AJAbanto/OpenEggscale/hardware/STL/lipo-charger-1.snapshot.1/Ladeprint.jpg

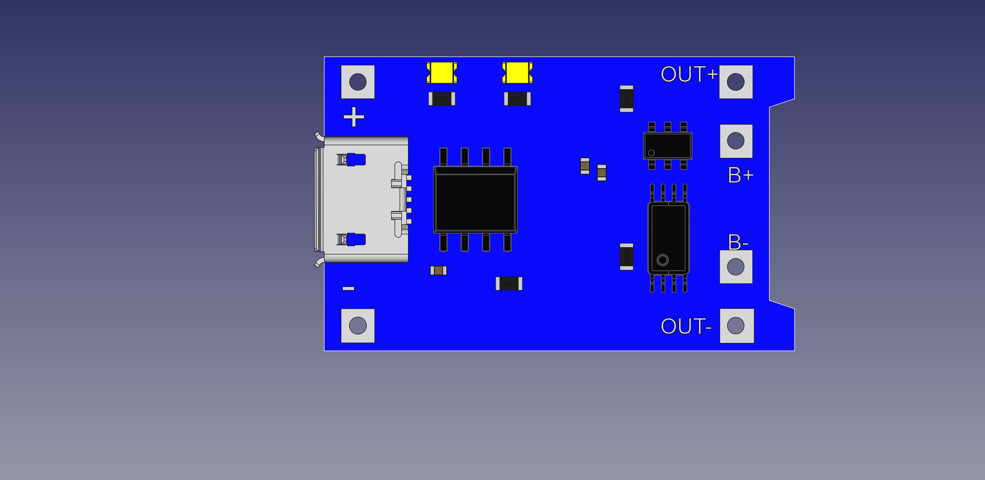
hardware/STL/lipo-charger-1.snapshot.1/Ladeprint.jpg
