AJAbanto/OpenEggscale/hardware/STL/boitier-2-accus-18650-2-slots-18650-battery-holder-1.snapshot.1/Boitier 18650 2 accus.jpg

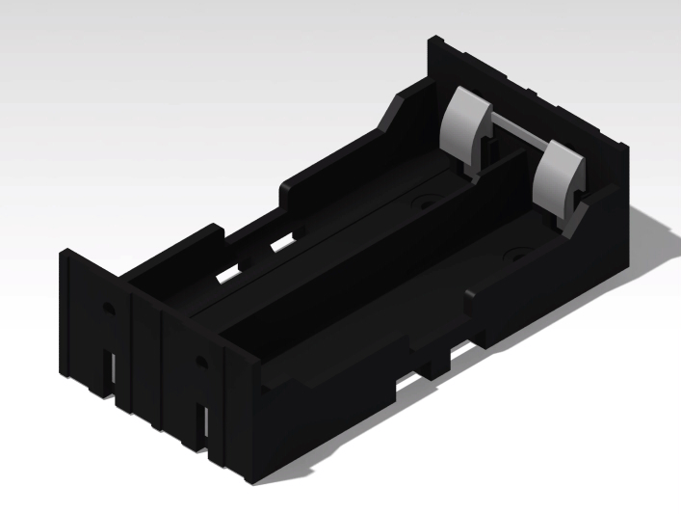
hardware/STL/boitier-2-accus-18650-2-slots-18650-battery-holder-1.snapshot.1/Boitier 18650 2 accus.jpg
