AJAbanto/OpenEggscale/hardware/KiCad/doc/Eggseg_BOM_egizmo.xlsx

Reference | Quantity | Value | Egizmo part | Footprint
C2 C1 | 2 | 22uF | 22UF 80% 25V 0805 | Capacitor_SMD:C_0805_2012Metric_Pad1.15x1.40mm_HandSolder
C3 | 1 | 100uF | 220uF / 10V | Capacitor_THT:CP_Radial_D8.0mm_P3.50mm
D1 | 1 | SS34-E3_57T | SK4200L-TP | SS34-E3_57T:DIOM7959X262N
J1 | 1 | V_charge | HB9500 | TerminalBlock:TerminalBlock_bornier-2_P5.08mm
L1 | 1 | 22uH | Power Inductor SMD 22uH | Inductor_SMD:L_10.4x10.4_H4.8
R3 R2 R1 | 3 | 1K | 1K 5% 0805 | Resistor_SMD:R_0603_1608Metric_Pad1.05x0.95mm_HandSolder
R4 | 1 | 2.2K | 2.2K 5% 0805 | Resistor_SMD:R_0603_1608Metric_Pad1.05x0.95mm_HandSolder
RV1 | 1 | 100K | MT-TR-200K64Z | Potentiometer_THT:Potentiometer_Bourns_3266W_Vertical
SW4 | 1 | PWR_SW | Toggle switch | Connector_PinHeader_2.54mm:PinHeader_1x03_P2.54mm_Vertical
U2 | 1 | MT3608 | MT3608 | Package_TO_SOT_SMD:SOT-23-6
