AJAbanto/OpenEggscale/hardware/STL/Base plate.stl

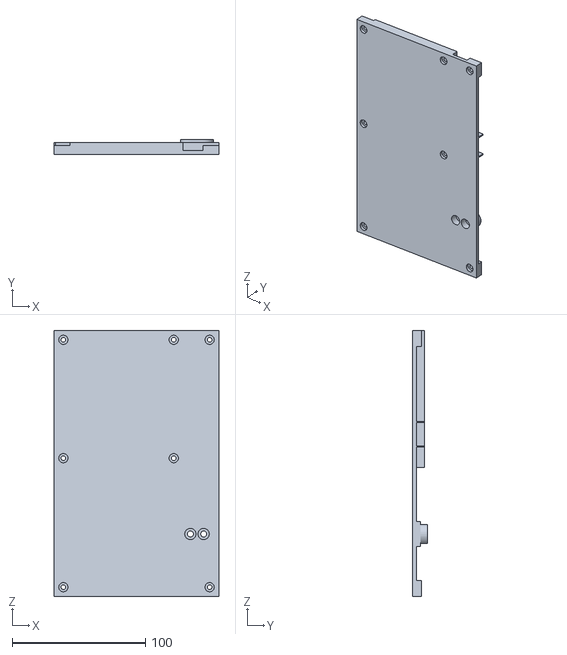
[picture p3: CAD file, 2020-08-23]
hardware/STL/Base plate.stl
124.0 x 11.5 x 200.0
