AJAbanto/OpenEggscale/hardware/STL/boitier-2-accus-18650-2-slots-18650-battery-holder-1.snapshot.1/Boitier 18650 2 accus.stp

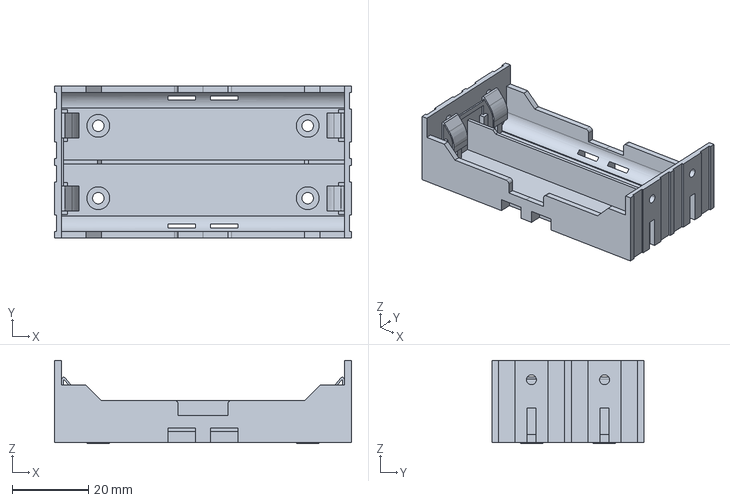
[picture p4: CAD file, 2020-08-23]
hardware/STL/boitier-2-accus-18650-2-slots-18650-battery-holder-1.snapshot.1/Boitier 18650 2 accus.stp
78.0 x 40.0 x 21.8 mm
