AJAbanto/OpenEggscale/hardware/STL/Eggplate.stl

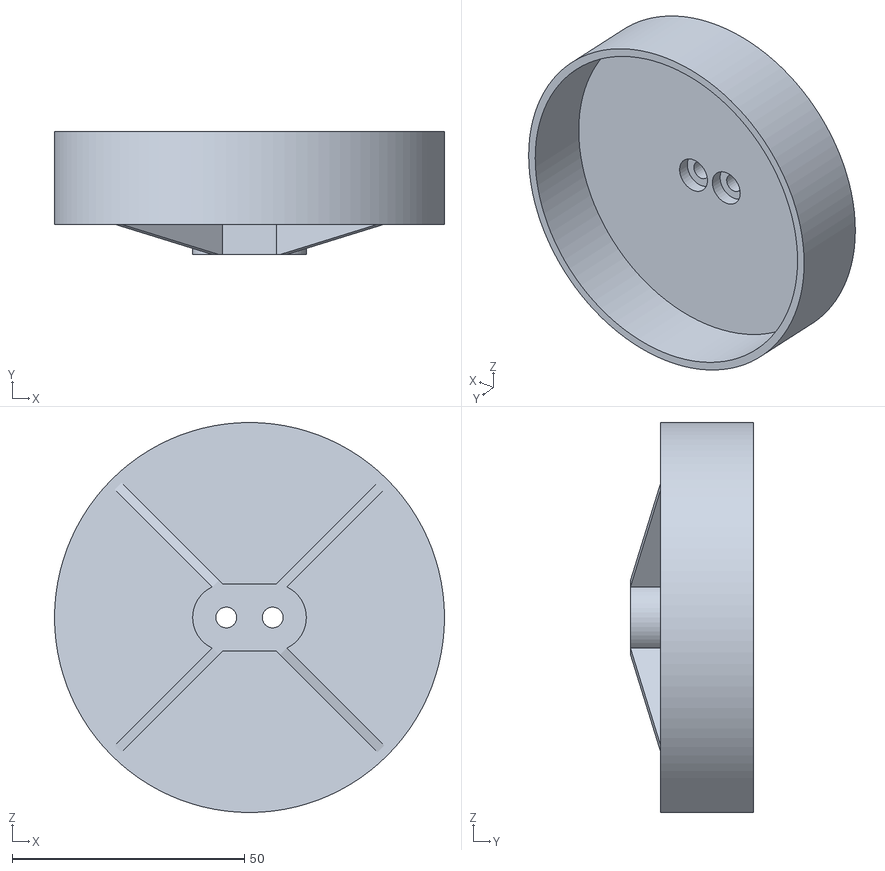
[picture p5: CAD file, 2020-08-12]
hardware/STL/Eggplate.stl
84.0 x 26.5 x 84.0
