AJAbanto/OpenEggscale/hardware/STL/menu button extension.stl

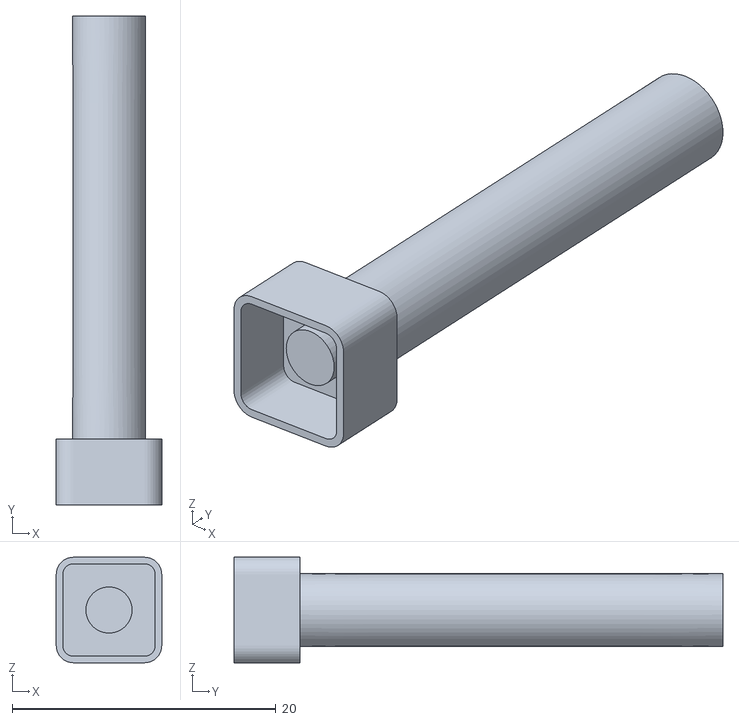
[picture p6: CAD file, 2020-08-12]
hardware/STL/menu button extension.stl
8.00 x 37.1 x 8.00
