AJAbanto/OpenEggscale/hardware/STL/Cover plate.stl

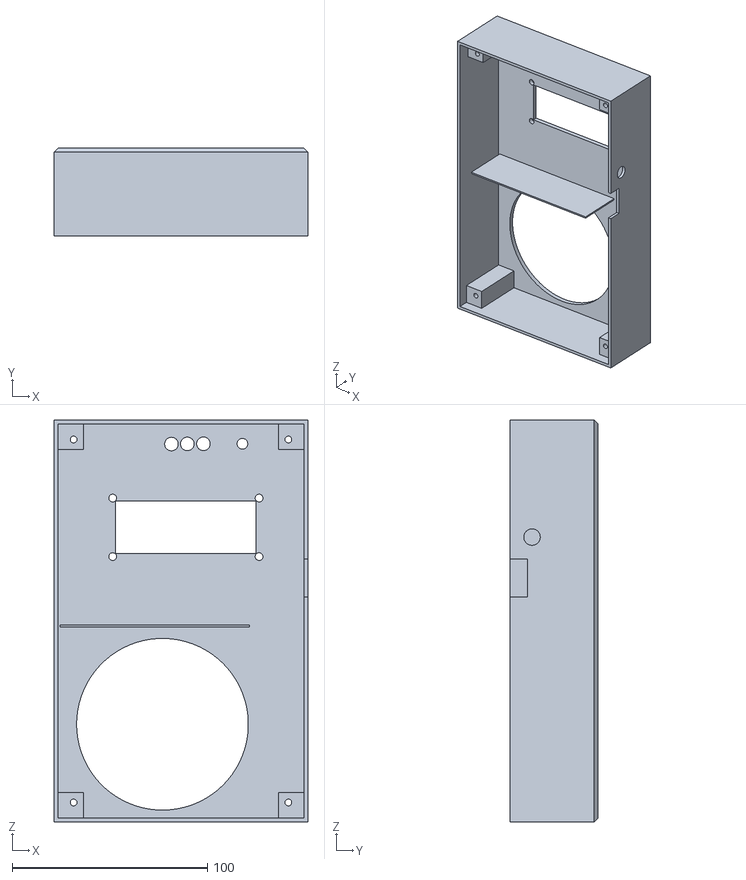
[picture p7: CAD file, 2020-08-12]
hardware/STL/Cover plate.stl
130.0 x 45.0 x 206.0
