AJAbanto/OpenEggscale/hardware/STL/button bracket.stl

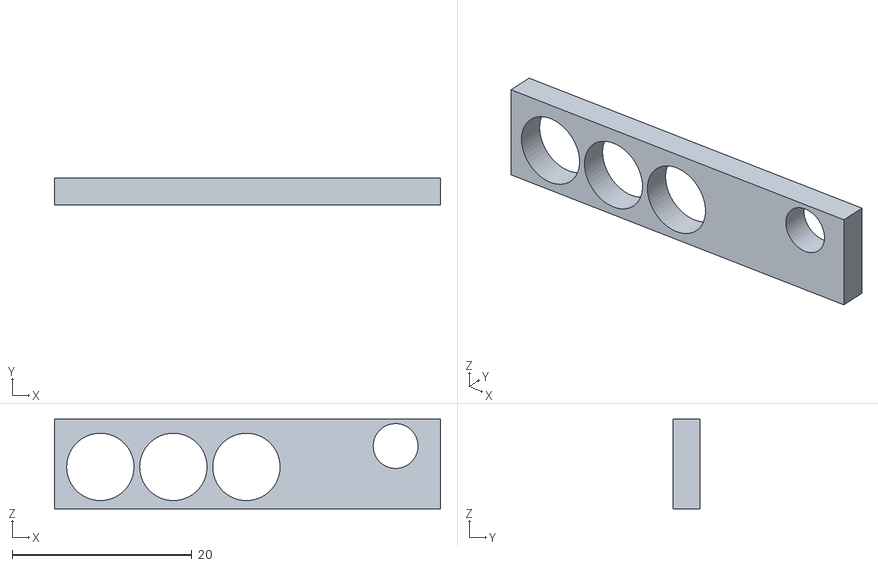
[picture p8: CAD file, 2020-08-12]
hardware/STL/button bracket.stl
43.0 x 3.00 x 10.0
