AJAbanto/OpenEggscale/hardware/KiCad/doc/Egg_segregator-F_Cu.pdf

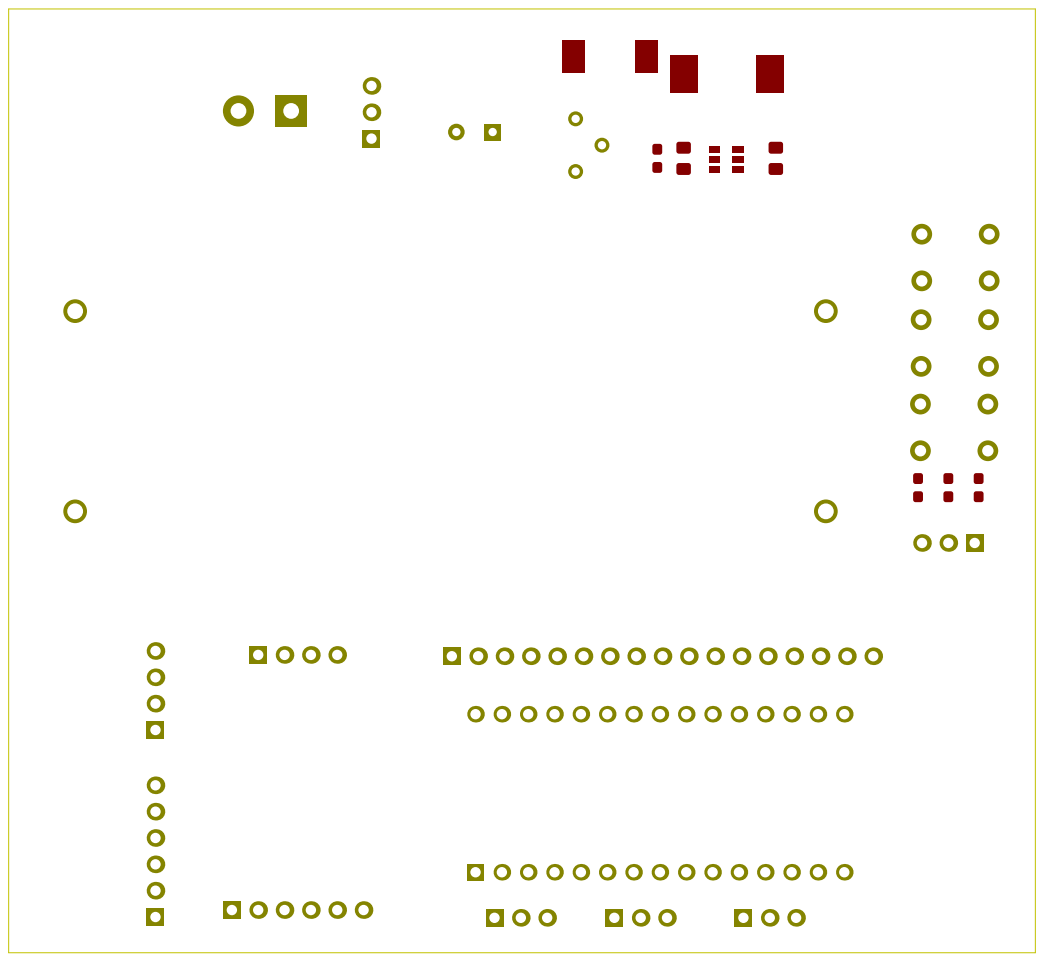
[picture p9: page 1]
