AJAbanto/OpenEggscale/(list of files, drawings)

Other design files:
hardware/KiCad/Egg_segregator.dsn
