AJAbanto/OpenEggscale/hardware/KiCad/Egg_segregator.kicad_pcb

## KiCad design hardware/KiCad/Egg_segregator.kicad_pcb (2020-08-23)

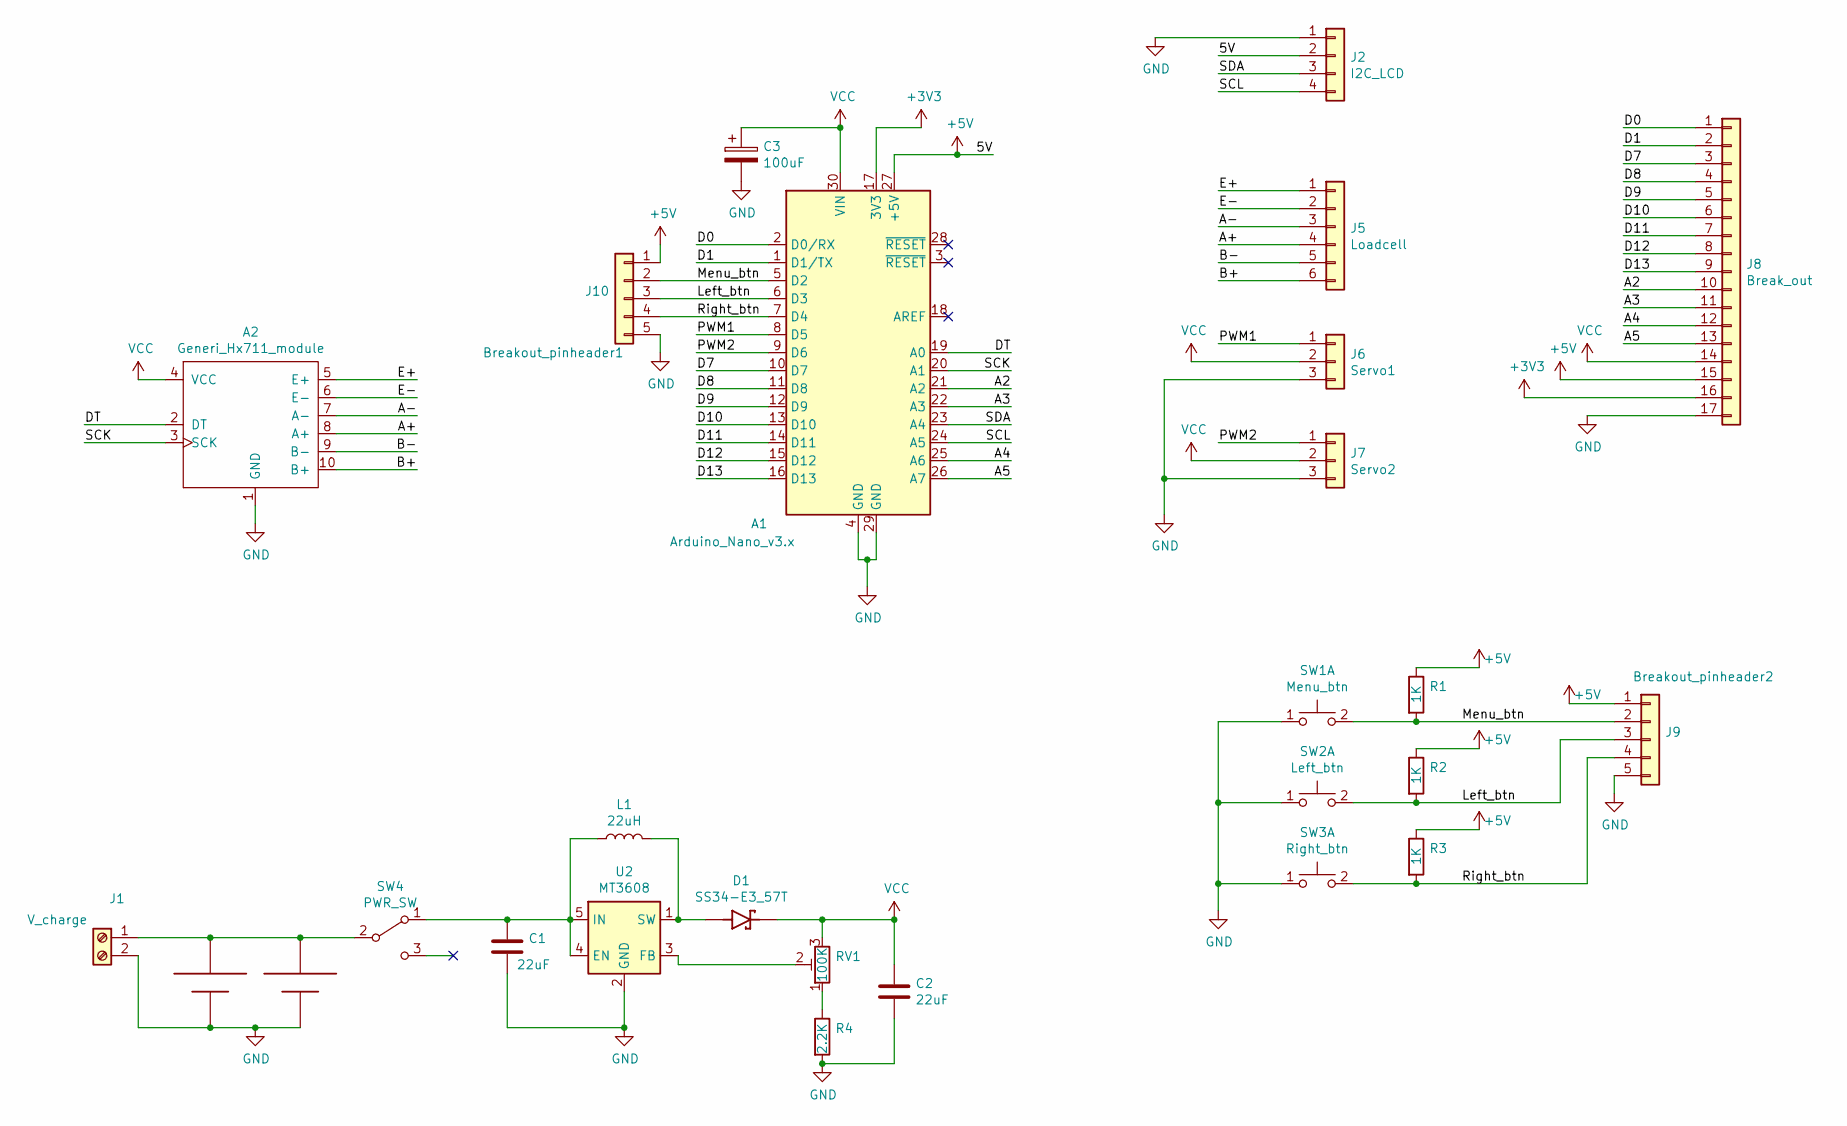
[picture p10: schematic Egg_segregator.sch, Egg segregator Interface board]

Parts:
A1: Arduino_Nano_v3.x; Arduino_Nano
A2: Generi_Hx711_module; Generic_Hx711_module
C1, C2: 22uF; C_0805_2012Metric_Pad1.15x1.40mm_HandSolder
C3: 100uF; CP_Radial_D8.0mm_P3.50mm
D1: SS34-E3_57T; DIOM7959X262N
J1: V_charge; TerminalBlock_bornier-2_P5.08mm
J2: I2C_LCD; PinSocket_1x04_P2.54mm_Vertical
J5: Loadcell; PinSocket_1x06_P2.54mm_Vertical
J6: Servo1; PinSocket_1x03_P2.54mm_Vertical
J7: Servo2; PinSocket_1x03_P2.54mm_Vertical
J8: Break_out; PinSocket_1x17_P2.54mm_Vertical
J9: Breakout_pinheader2; PinSocket_1x05_P2.54mm_Vertical
J10: Breakout_pinheader1; PinSocket_1x05_P2.54mm_Vertical
L1: 22uH; L_10.4x10.4_H4.8
R1, R2, R3: 1K; R_0603_1608Metric_Pad1.05x0.95mm_HandSolder
R4: 2.2K; R_0603_1608Metric_Pad1.05x0.95mm_HandSolder
RV1: 100K; Potentiometer_Bourns_3266W_Vertical
SW1: Menu_btn; SW_PUSH_6mm
SW2: Left_btn; SW_PUSH_6mm
SW3: Right_btn; SW_PUSH_6mm
SW4: PWR_SW; PinHeader_1x03_P2.54mm_Vertical
U1: BK-18650-PC4; 18650-PC4
U2: MT3608; SOT-23-6

Connections:
+3V3: A1.17 (3V3), J8.16
+5V: A1.27 (+5V), J2.2, J8.15, J9.1, J10.1, R1.1, R2.1, R3.1
/A2: A1.21 (A2), J8.10
/A3: A1.22 (A3), J8.11
/A4: A1.25 (A6), J8.12
/A5: A1.26 (A7), J8.13
/A+: A2.8 (A+), J5.4
/A-: A2.7 (A-), J5.3
/B+: A2.10 (B+), J5.6
/B-: A2.9 (B-), J5.5
/D0: A1.2 (D0/RX), J8.1
/D1: A1.1 (D1/TX), J8.2
/D7: A1.10 (D7), J8.3
/D8: A1.11 (D8), J8.4
/D9: A1.12 (D9), J8.5
/D10: A1.13 (D10), J8.6
/D11: A1.14 (D11), J8.7
/D12: A1.15 (D12), J8.8
/D13: A1.16 (D13), J8.9
/DT: A1.19 (A0), A2.2 (DT)
/E+: A2.5 (E+), J5.1
/E-: A2.6 (E-), J5.2
/Left_btn: A1.6 (D3), J9.3, J10.3, R2.2, SW2.2 (D)
/Menu_btn: A1.5 (D2), J9.2, J10.2, R1.2, SW1.2 (D)
/PWM1: A1.8 (D5), J6.1
/PWM2: A1.9 (D6), J7.1
/Right_btn: A1.7 (D4), J9.4, J10.4, R3.2, SW3.2 (D)
/SCK: A1.20 (A1), A2.3 (SCK)
/SCL: A1.24 (A5), J2.4
/SDA: A1.23 (A4), J2.3
GND: A1.4 (GND), A1.29 (GND), A2.1 (GND), C1.2, C2.2, C3.2, J1.2, J2.1, J6.3, J7.3, J8.17, J9.5, J10.5, R4.2, SW1.1 (C), SW2.1 (C), SW3.1 (C), U1.1 (-1), U1.2 (-2), U2.2 (GND)
unnamed: C1.1, L1.1, SW4.1 (A), U2.4 (EN), U2.5 (IN)
unnamed: D1.A, L1.2, U2.1 (SW)
unnamed: J1.1, SW4.2 (B), U1.+1, U1.+2
unnamed: R4.1, RV1.1
unnamed: RV1.2, U2.3 (FB)
VCC: A1.30 (VIN), A2.4 (VCC), C2.1, C3.1, D1.C, J6.2, J7.2, J8.14, RV1.3

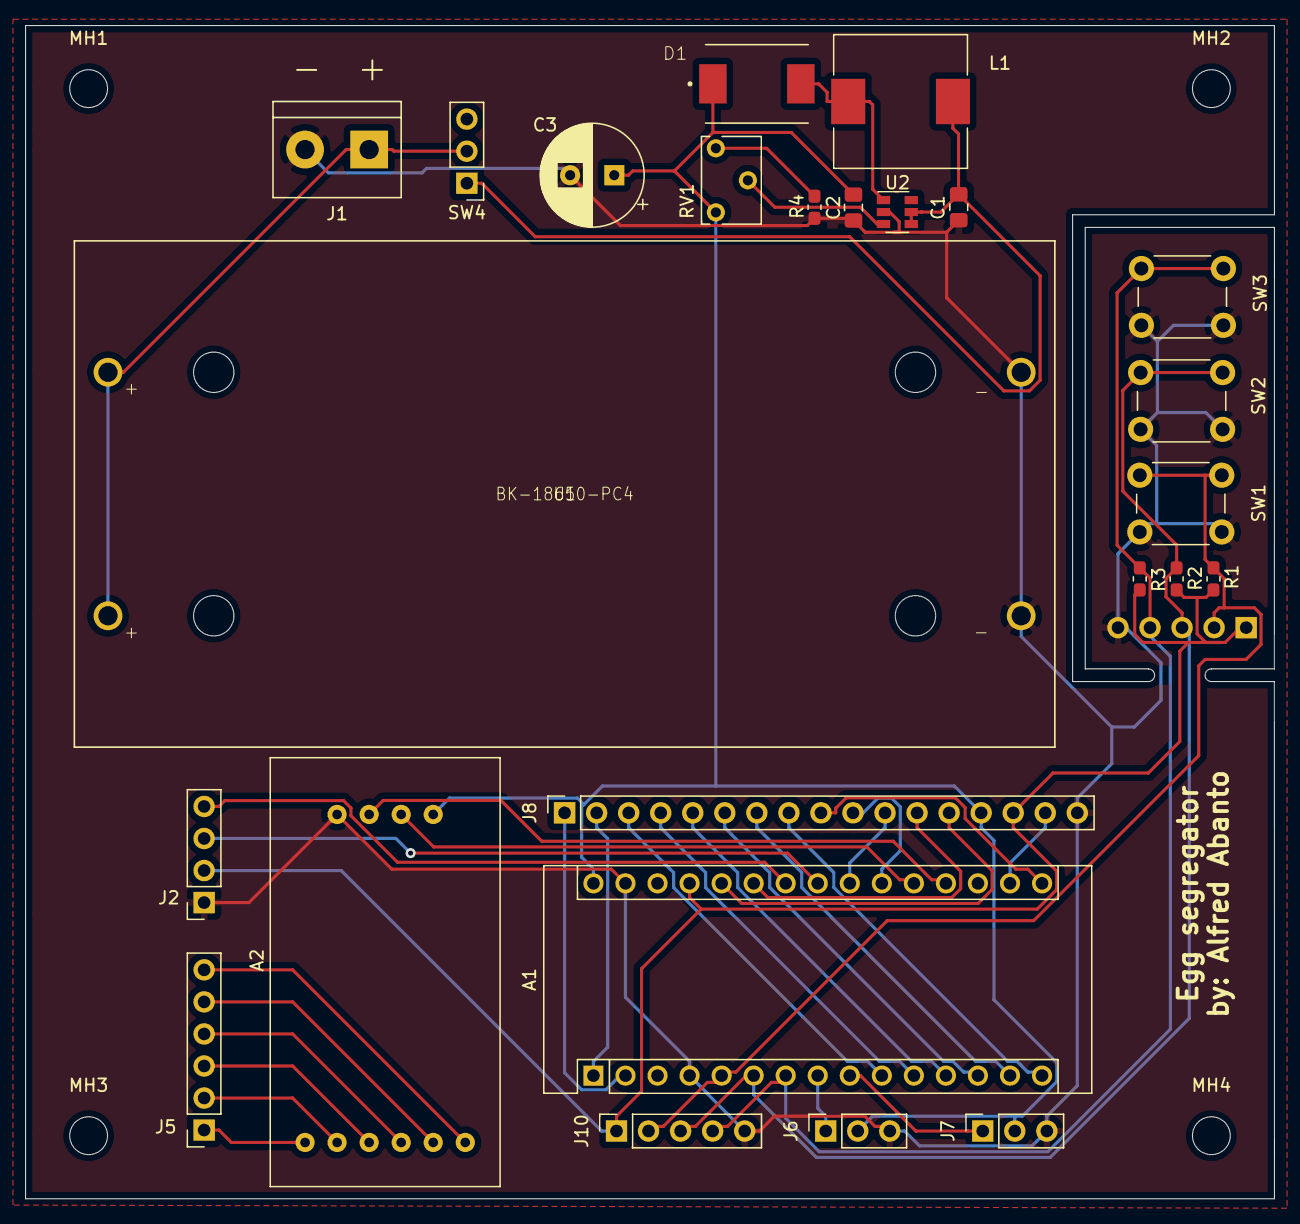
[picture p11: board Egg_segregator.kicad_pcb from above]

Board: 2 copper layers, 99.0 x 93.0 mm, 30 parts (1 on the bottom side), 37 nets.

Other parts of the board:
MH1, MH2, MH3, MH4: MountingHole_3mm
