AJAbanto/OpenEggscale/(commit log)

2020-08-12 Initial upload of files
    Initial upload of files
    [Base plate.stl, Cover plate.stl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]
2020-08-13 offset current threshold and uploaded into eeprom
    updated current threshold for first round of testing.
2020-08-23 software updates and file organization
    Added some software updates and pcb changes
    [Base plate.stl, Boitier 18650 2 accus.stp, Egg_segregator.kicad_pcb]
